DavidMcEwan/mcdox/pcb/hand/hand.kicad_pcb

## KiCad design pcb/hand/hand.kicad_pcb (2023-03-12)

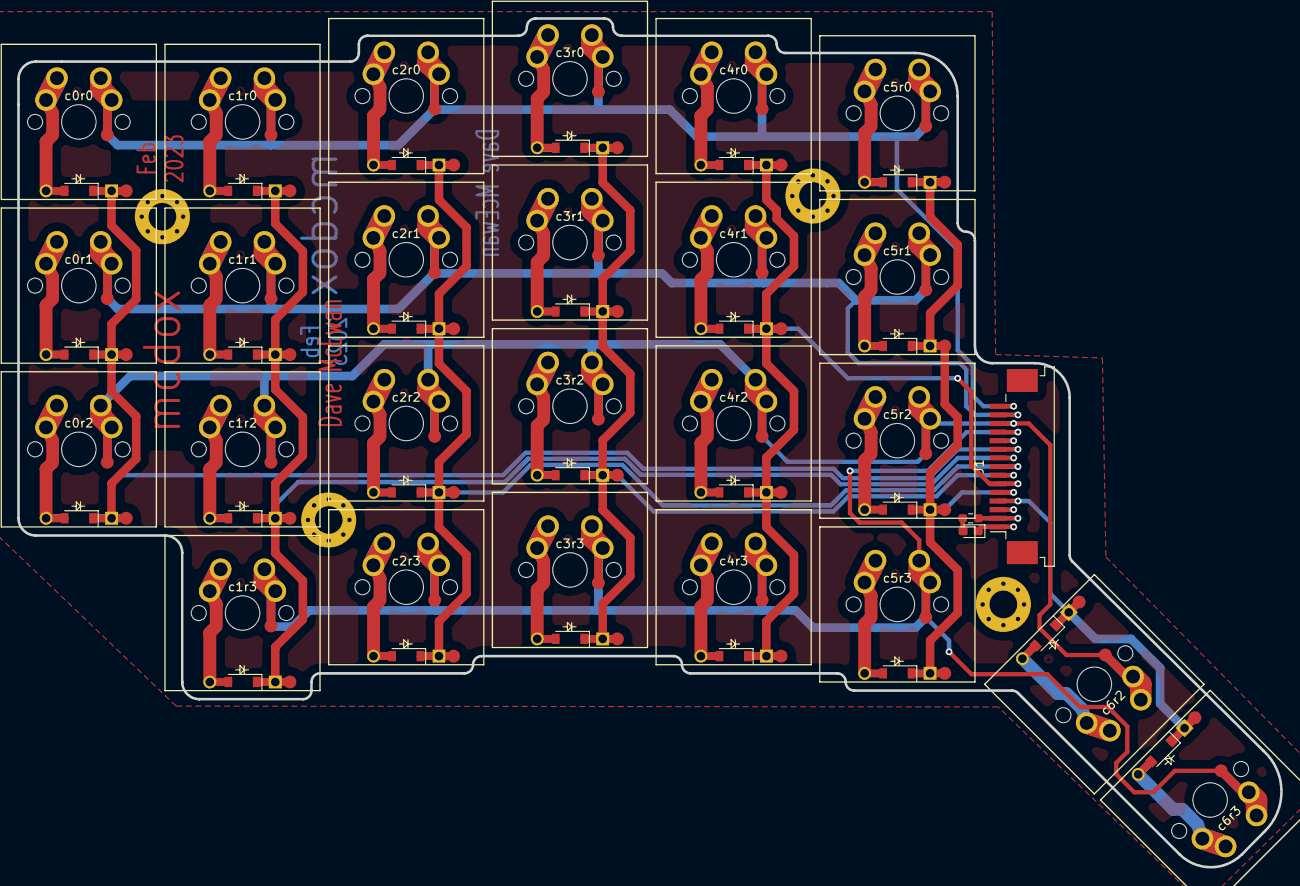
[picture p1: board hand.kicad_pcb from above]

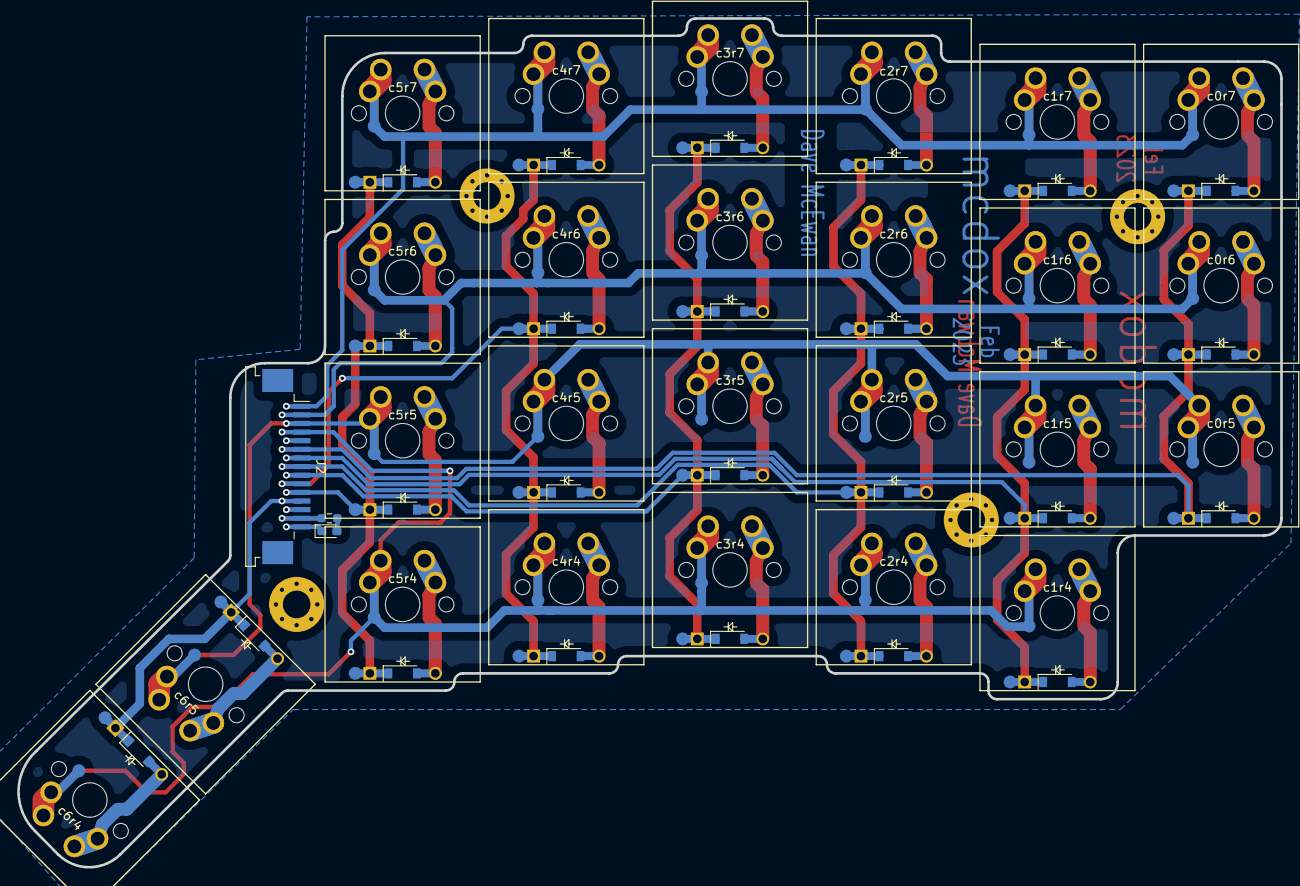
[picture p2: board hand.kicad_pcb from below]

Board: 2 copper layers, 146.6 x 98.5 mm, 35 parts (5 on the bottom side), 17 nets.

Parts:
H1, H2, H3, H4: MountingHole_3.2mm_M3_Pad_Via
J1, J2: Conn_01x15; TE_1-84953-5_1x15-1MP_P1.0mm_Horizontal
LED1, LED2: LED; D_0603_1608Metric_Pad1.05x0.95mm_HandSolder
R1, R2: 220; R_0603_1608Metric_Pad0.98x0.95mm_HandSolder
c0r0, c0r1, c0r2, c1r0, c1r1, c1r2, c1r3, c2r0, c2r1, c2r2, c2r3, c3r0, c3r1, c3r2, c3r3, c4r0, c4r1, c4r2, c4r3, c5r0, c5r1, c5r2, c5r3, c6r2, c6r3: switchDiode; reversibleMX_10u

Connections:
+3V3: J1.2, J2.14, R1.1, R2.1
GND: J1.1, J2.15, LED1.1, LED2.1
unnamed: LED1.2, R1.2
unnamed: LED2.2, R2.2
col0: J1.10, J2.6, c0r0.2, c0r1.2, c0r2.2
col1: J1.9, J2.7, c1r0.2, c1r1.2, c1r2.2, c1r3.2
col2: J1.8, J2.8, c2r0.2, c2r1.2, c2r2.2, c2r3.2
col3: J1.7, J2.9, c3r0.2, c3r1.2, c3r2.2, c3r3.2
col4: J1.6, J2.10, c4r0.2, c4r1.2, c4r2.2, c4r3.2
col5: J1.5, J2.11, c5r0.2, c5r1.2, c5r2.2, c5r3.2
col6: J1.4, J2.12, c6r2.2, c6r3.2
col7_NC: J1.3, J2.13
row0: J1.15, J2.1, c0r0.1, c1r0.1, c2r0.1, c3r0.1, c4r0.1, c5r0.1
row1: J1.14, J2.2, c0r1.1, c1r1.1, c2r1.1, c3r1.1, c4r1.1, c5r1.1
row2: J1.13, J2.3, c0r2.1, c1r2.1, c2r2.1, c3r2.1, c4r2.1, c5r2.1, c6r2.1
row3: J1.12, J2.4, c1r3.1, c2r3.1, c3r3.1, c4r3.1, c5r3.1, c6r3.1
row4_NC: J1.11, J2.5
