DavidMcEwan/mcdox/pcb/ctrl/ctrl.kicad_pcb

## KiCad design pcb/ctrl/ctrl.kicad_pcb (2023-03-12)

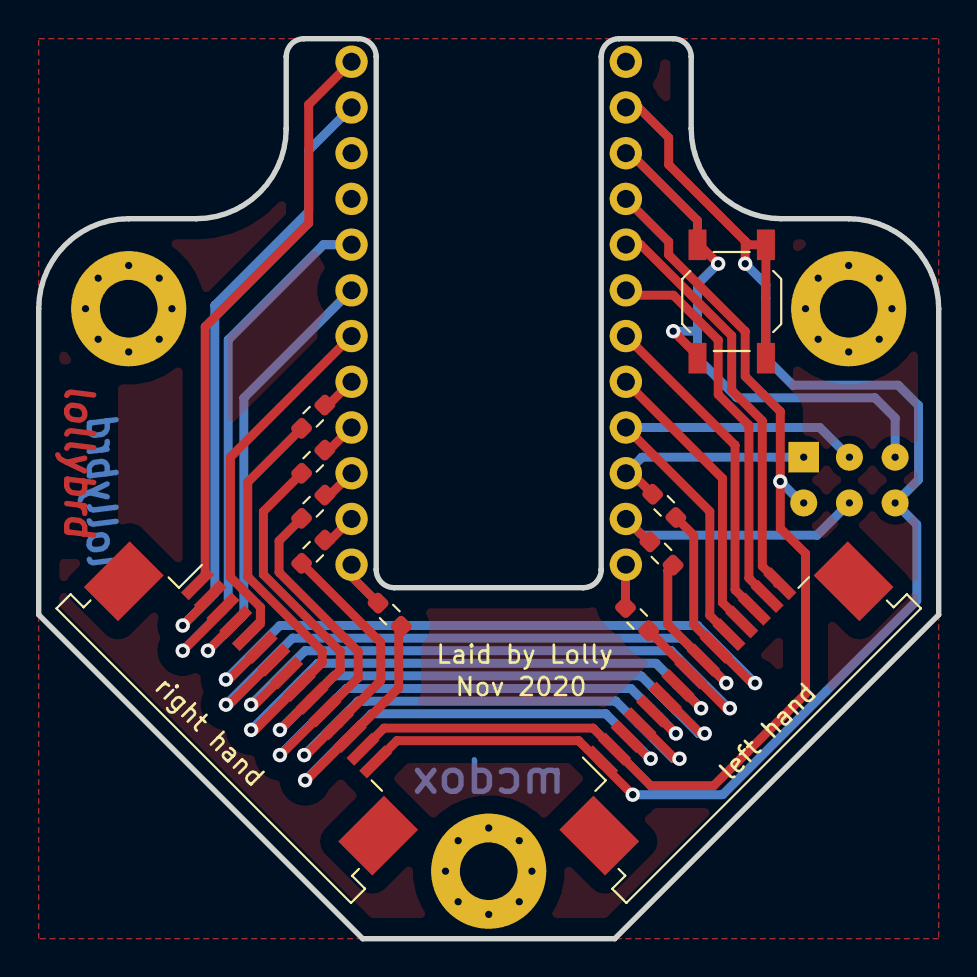
[picture p3: board ctrl.kicad_pcb from above]

Board: 2 copper layers, 50.0 x 50.0 mm, 13 parts (1 on the bottom side), 29 nets.

Parts:
ICSP: Conn_02x03_Odd_Even; PinHeader_2x03_P2.54mm_Vertical
Jleft1: Conn_01x15; TE_1-84953-5_1x15-1MP_P1.0mm_Horizontal
Jright1: Conn_01x15; TE_1-84953-5_1x15-1MP_P1.0mm_Horizontal
R0, R1, R2, R3, R4, R5, R6, R7: 220; R_0603_1608Metric_Pad0.98x0.95mm_HandSolder
SW1: SW_Push; SW_SPST_TL3342
U1: ArduinoProMicro

Connections:
GND: ICSP.6, Jleft1.1, Jright1.15, SW1.2, U1.14
MISO: ICSP.1, R0.2, U1.22
MOSI: ICSP.4, R1.2, U1.23
unnamed: R2.2, U1.24
unnamed: R3.2, U1.12
unnamed: R4.2, U1.11
unnamed: R5.2, U1.10
unnamed: R6.2, U1.9
unnamed: R7.2, U1.8
RST: ICSP.5, SW1.1, U1.15
SCK: ICSP.3, Jleft1.11, U1.21
VCC: ICSP.2, Jleft1.2, Jright1.14, U1.16
col0: Jleft1.10, Jright1.6, R0.1
col1: Jleft1.9, Jright1.7, R1.1
col2: Jleft1.8, Jright1.8, R2.1
col3: Jleft1.7, Jright1.9, R7.1
col4: Jleft1.6, Jright1.10, R6.1
col5: Jleft1.5, Jright1.11, R5.1
col6: Jleft1.4, Jright1.12, R4.1
col7: Jleft1.3, Jright1.13, R3.1
row0: Jright1.1, U1.1
row1: Jright1.2, U1.2
row2: Jright1.3, U1.5
row3: Jright1.4, U1.6
row4: Jright1.5, U1.7
row6: Jleft1.12, U1.20
row7: Jleft1.13, U1.19
row8: Jleft1.14, U1.18
row9: Jleft1.15, U1.17
