DavidMcEwan/mcdox/(commit log)

2022-01-14 case.svg Move weight-saving cut to avoid filling with dust.
2022-01-14 case.svg Increase margin on coverTop to avoid squeeky keycaps.
2022-01-14 case.svg Move PCB cutouts to ease plugging FPC cables.
2023-01-21 case Remove 2 bolts.
    - Enlarge weight-saving cutout.
    - Add cutouts to innerTop.
    - Remove/move bolts under wrists.
    - New bolt position should fit more nicely into base of thumb/palm.
2023-01-21 case Note violation on innerTop.
2023-01-21 case Name layers in layerstack.svg to match case.svg
2023-01-21 case/layerstack Add dev copy for things I'm unsure about.
2023-01-21 pcb/hand Reduce switch array to 5 rows, 6 columns.
    - Simple intuitive mapping in sw.
    - Requires 16 GPIO for a pair. (6 + 2*5)
    [hand.sch]
2023-01-21 pcb/hand Rearrange switch array to 4 rows, 7 columns.
    - Less intuitive mapping in sw, but can use a pp macro.
    - Requires 15 GPIO for a pair. (7 + 2*4)
    [hand.sch]
2023-01-21 pcb/hand 1u keycaps for all switches
    [hand.sch]
2023-01-21 pcb/hand NC to clean up most DRC
    [hand.sch]
2023-01-21 pcb/hand Begin layout and edges.
    [hand.kicad_pcb]
2023-01-27 pcb/hand Layout finger cluster.
    [hand.kicad_pcb, hand.sch]
2023-01-27 pcb/hand Route and fill
    [hand.kicad_pcb]
2023-01-27 pcb/hand Begin tidying DRC.
    TODO:
    - Name
    - Date
    - Connect J1 to J2
    - Finish DRC
    [hand.kicad_pcb]
2023-02-05 pcb/hand Recess cutout under switches on Eco2.User
    Remove all the pad-to-pad tracks too... Loads of them!
    [hand.kicad_pcb]
2023-02-05 pcb/hand Full layout.
    [hand.kicad_pcb, hand.sch]
2023-02-05 pcb/hand Generate SVG for case.
2023-02-19 case Remove layerstack_dev and layerstack_future
2023-02-19 case Complete revamp of layerstackPalette.
2023-03-12 case PCB and outline placement.
    Can fit all 5 layers on a single 400x600mm sheet.
    [ctrl.kicad_pcb, hand.kicad_pcb]
2023-03-17 case First draft of mount and coverBottom. Started pcbProfile.
2023-03-24 case Reduce socket hole diameters to from 6mm to 5.4mm
    Looks like too much space on my current red/black one.
2023-03-24 case Group parts on pcb.F.Fab
    Preparation for (maybe) moving ctrl upwards.
2023-03-24 case cut.innerTop
